AndersBNielsen/Relatively-Universal-ROM-Programmer/(notices)

Notices in the files:
hardware/RelativelyUniversalROMProgrammer.kicad_sch:
\"Insert some open permissive hardware license here\"
